itscool2b/AquaSense/hardware/kicad/aquasense.kicad_sch

## KiCad design hardware/kicad/aquasense.kicad_sch (2026-08-13, last stored version)

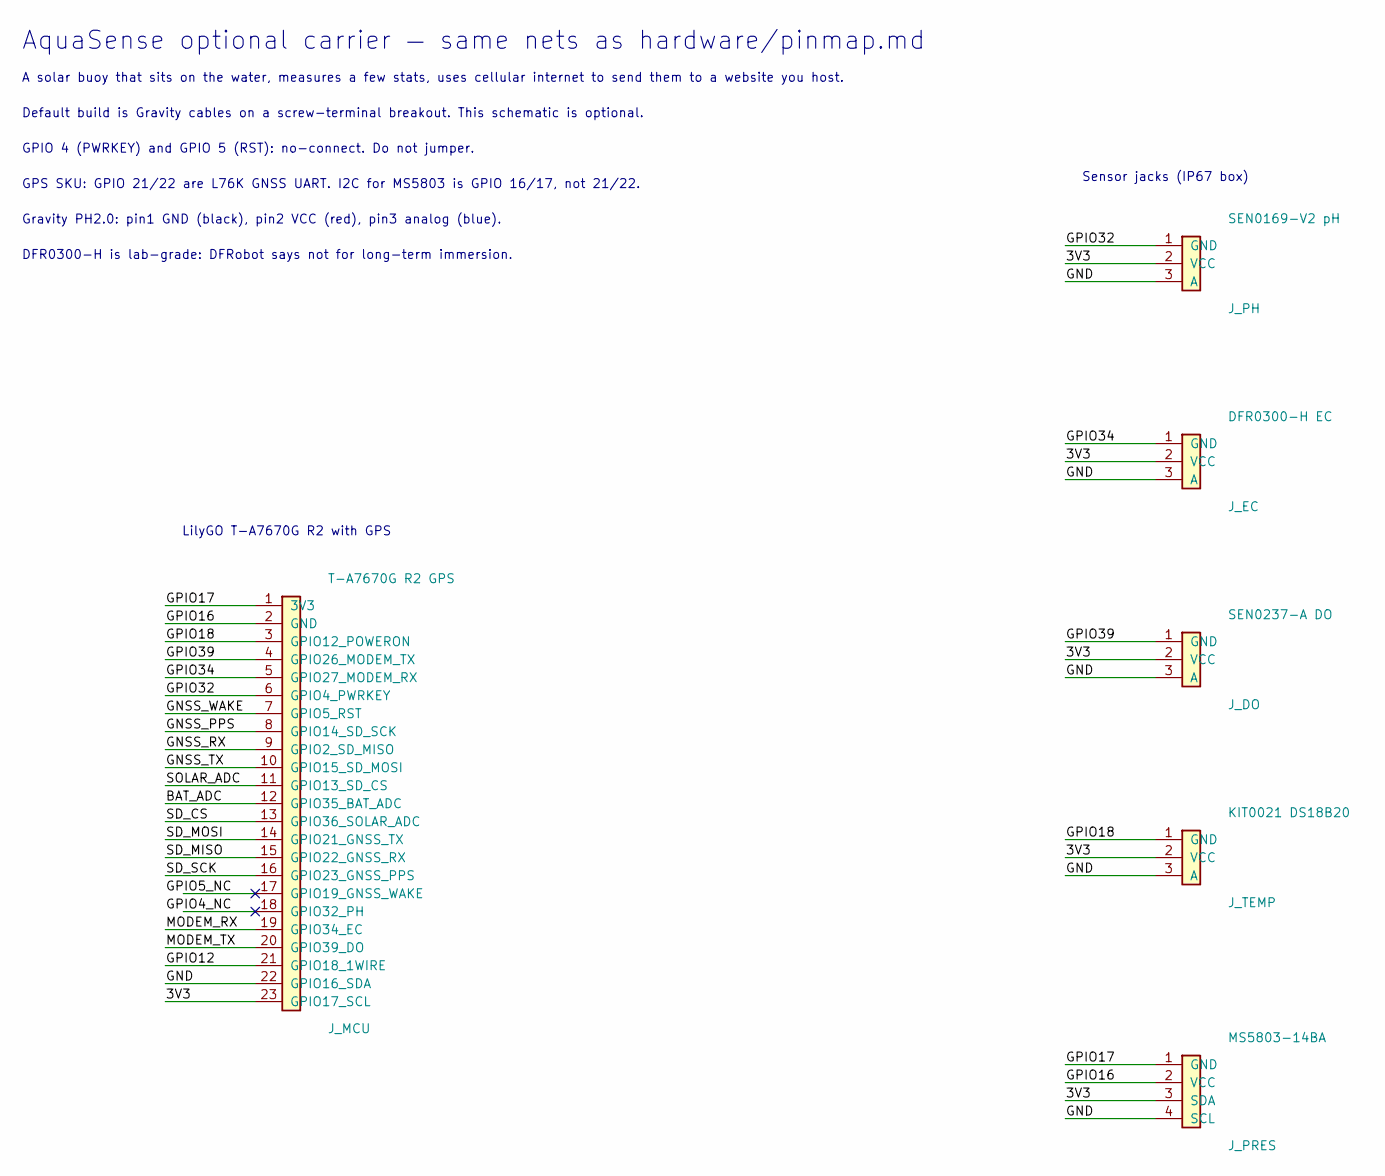
[picture p3: schematic aquasense.kicad_sch]

Parts:
J_DO: SEN0237-A DO
J_EC: DFR0300-H EC
J_MCU: T-A7670G R2 GPS
J_PH: SEN0169-V2 pH
J_PRES: MS5803-14BA
J_TEMP: KIT0021 DS18B20

Connections:
3V3: J_DO.2 (VCC), J_EC.2 (VCC), J_MCU.23 (GPIO17_SCL), J_PH.2 (VCC), J_PRES.3 (SDA), J_TEMP.2 (VCC)
BAT_ADC: J_MCU.12 (GPIO35_BAT_ADC)
GND: J_DO.3 (A), J_EC.3 (A), J_MCU.22 (GPIO16_SDA), J_PH.3 (A), J_PRES.4 (SCL), J_TEMP.3 (A)
GNSS_PPS: J_MCU.8 (GPIO14_SD_SCK)
GNSS_RX: J_MCU.9 (GPIO2_SD_MISO)
GNSS_TX: J_MCU.10 (GPIO15_SD_MOSI)
GNSS_WAKE: J_MCU.7 (GPIO5_RST)
GPIO12: J_MCU.21 (GPIO18_1WIRE)
GPIO16: J_MCU.2 (GND), J_PRES.2 (VCC)
GPIO17: J_MCU.1 (3V3), J_PRES.1 (GND)
GPIO18: J_MCU.3 (GPIO12_POWERON), J_TEMP.1 (GND)
GPIO32: J_MCU.6 (GPIO4_PWRKEY), J_PH.1 (GND)
GPIO34: J_EC.1 (GND), J_MCU.5 (GPIO27_MODEM_RX)
GPIO39: J_DO.1 (GND), J_MCU.4 (GPIO26_MODEM_TX)
MODEM_RX: J_MCU.19 (GPIO34_EC)
MODEM_TX: J_MCU.20 (GPIO39_DO)
SD_CS: J_MCU.13 (GPIO36_SOLAR_ADC)
SD_MISO: J_MCU.15 (GPIO22_GNSS_RX)
SD_MOSI: J_MCU.14 (GPIO21_GNSS_TX)
SD_SCK: J_MCU.16 (GPIO23_GNSS_PPS)
SOLAR_ADC: J_MCU.11 (GPIO13_SD_CS)

Notes on the sheet:
AquaSense optional carrier — same nets as hardware/pinmap.md
A solar buoy that sits on the water, measures a few stats, uses cellular internet to send them to a website you host.
Default build is Gravity cables on a screw-terminal breakout. This schematic is optional.
GPIO 4 (PWRKEY) and GPIO 5 (RST): no-connect. Do not jumper.
GPS SKU: GPIO 21/22 are L76K GNSS UART. I2C for MS5803 is GPIO 16/17, not 21/22.
Gravity PH2.0: pin1 GND (black), pin2 VCC (red), pin3 analog (blue).
DFR0300-H is lab-grade: DFRobot says not for long-term immersion.
LilyGO T-A7670G R2 with GPS
Sensor jacks (IP67 box)
