itscool2b/AquaSense/(commit log)

2026-08-13 Add a single BOM with SKU, price, buy, and datasheet on every row.
    Street prices from manufacturer pages (2026-08-12). GPS T-A7670G only; no turbidity.
    [bom.csv]
2026-08-13 Add Gravity wiring, exploded hull, and LilyGO pin map.
    Default build is screw terminals, not a custom PCB. KiCad remains optional.
    [tray.scad]
2026-08-13 Add T-A7670G firmware with LTE HTTPS POST and cited conversions.
    TinyGSM-fork, ESP32 millivolt ADC, PSS-78 salinity and Benson-Krause DO tests.
2026-08-13 Make hull drawings, wiring, and dashboard match the actual kit.
    Regenerate hero and isometric for a 24 in PVC square, Pelican 1120, solar on the lid, and five sensors. Wiring SVG uses Gravity red/black/blue plus GPIO. Dashboard now has 24h/7d charts and a map. BOM adds inner-float caps. Levin cuts are in the hull steps.
    [bom.csv]
2026-08-13 Add DO two-point calibration, KiCad netlist, and Pages fallback.
    Dissolved oxygen is no longer a fake 0–20 mg/L scale: two-point millivolts
    live in NVS, uncalibrated POSTs send null. Serial waits 12s for cal.
    Battery volts cite LilyGO ReadBattery.ino (V1.2+ ×2). Optional KiCad
    schematic matches the pin map. Pages also publishes the gh-pages branch
    so the docs site can go live without the Actions Pages environment.
    [aquasense.kicad_sch]
2026-10-07 AquaSense v1.0: ESP32 pH, ORP and temperature monitor
    An ESP32 reads isolated Atlas Scientific EZO-pH and EZO-ORP boards over
    I2C plus a DS18B20 temperature probe, shows live values on an OLED
    display, and uploads them over Wi-Fi to a self-hosted server and dashboard.
    - firmware: ESP32 firmware (temperature-compensated pH, averaging,
    bad-reading rejection, Wi-Fi reconnect, settings in flash, calibration
    commands), one test sketch per build layer, filter unit tests
    - selfhost: Postgres measurements table, 1h/24h/7d/30d history,
    alert rules with tests, optional phone notifications, web dashboard
    - hardware, bom: wiring, pin map, enclosure, power safety, parts list
    - README: what it is,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
    [aquasense.kicad_sch, bom.csv, tray.scad]
2026-10-31 Add Tibet-Butler Preserve deployment to README
    AquaSense is running in the alligator tank at Tibet-Butler Preserve
    (Orange County, FL), providing constant pH, ORP, and temperature readings.
    Claude-Session: https://claude.ai/code/session_0198JUC4C6TyubDSxYrEkg9X
