itscool2b/AquaSense/(notices)

Notices in the files:
hardware/kicad/aquasense.kicad_sch:
AquaSense / CERN-OHL-S-2.0
README.md:
Hardware: CERN-OHL-S-2.0
Docs: CC BY 4.0
